mwuerms/ledtimer/(list of files, cad)

Other CAD files:
openscad/LT2/parts.scad
