mwuerms/ledtimer/kicad/LT2/rev0/LT2.kicad_pcb

## KiCad design kicad/LT2/rev0/LT2.kicad_pcb (2025-10-19)

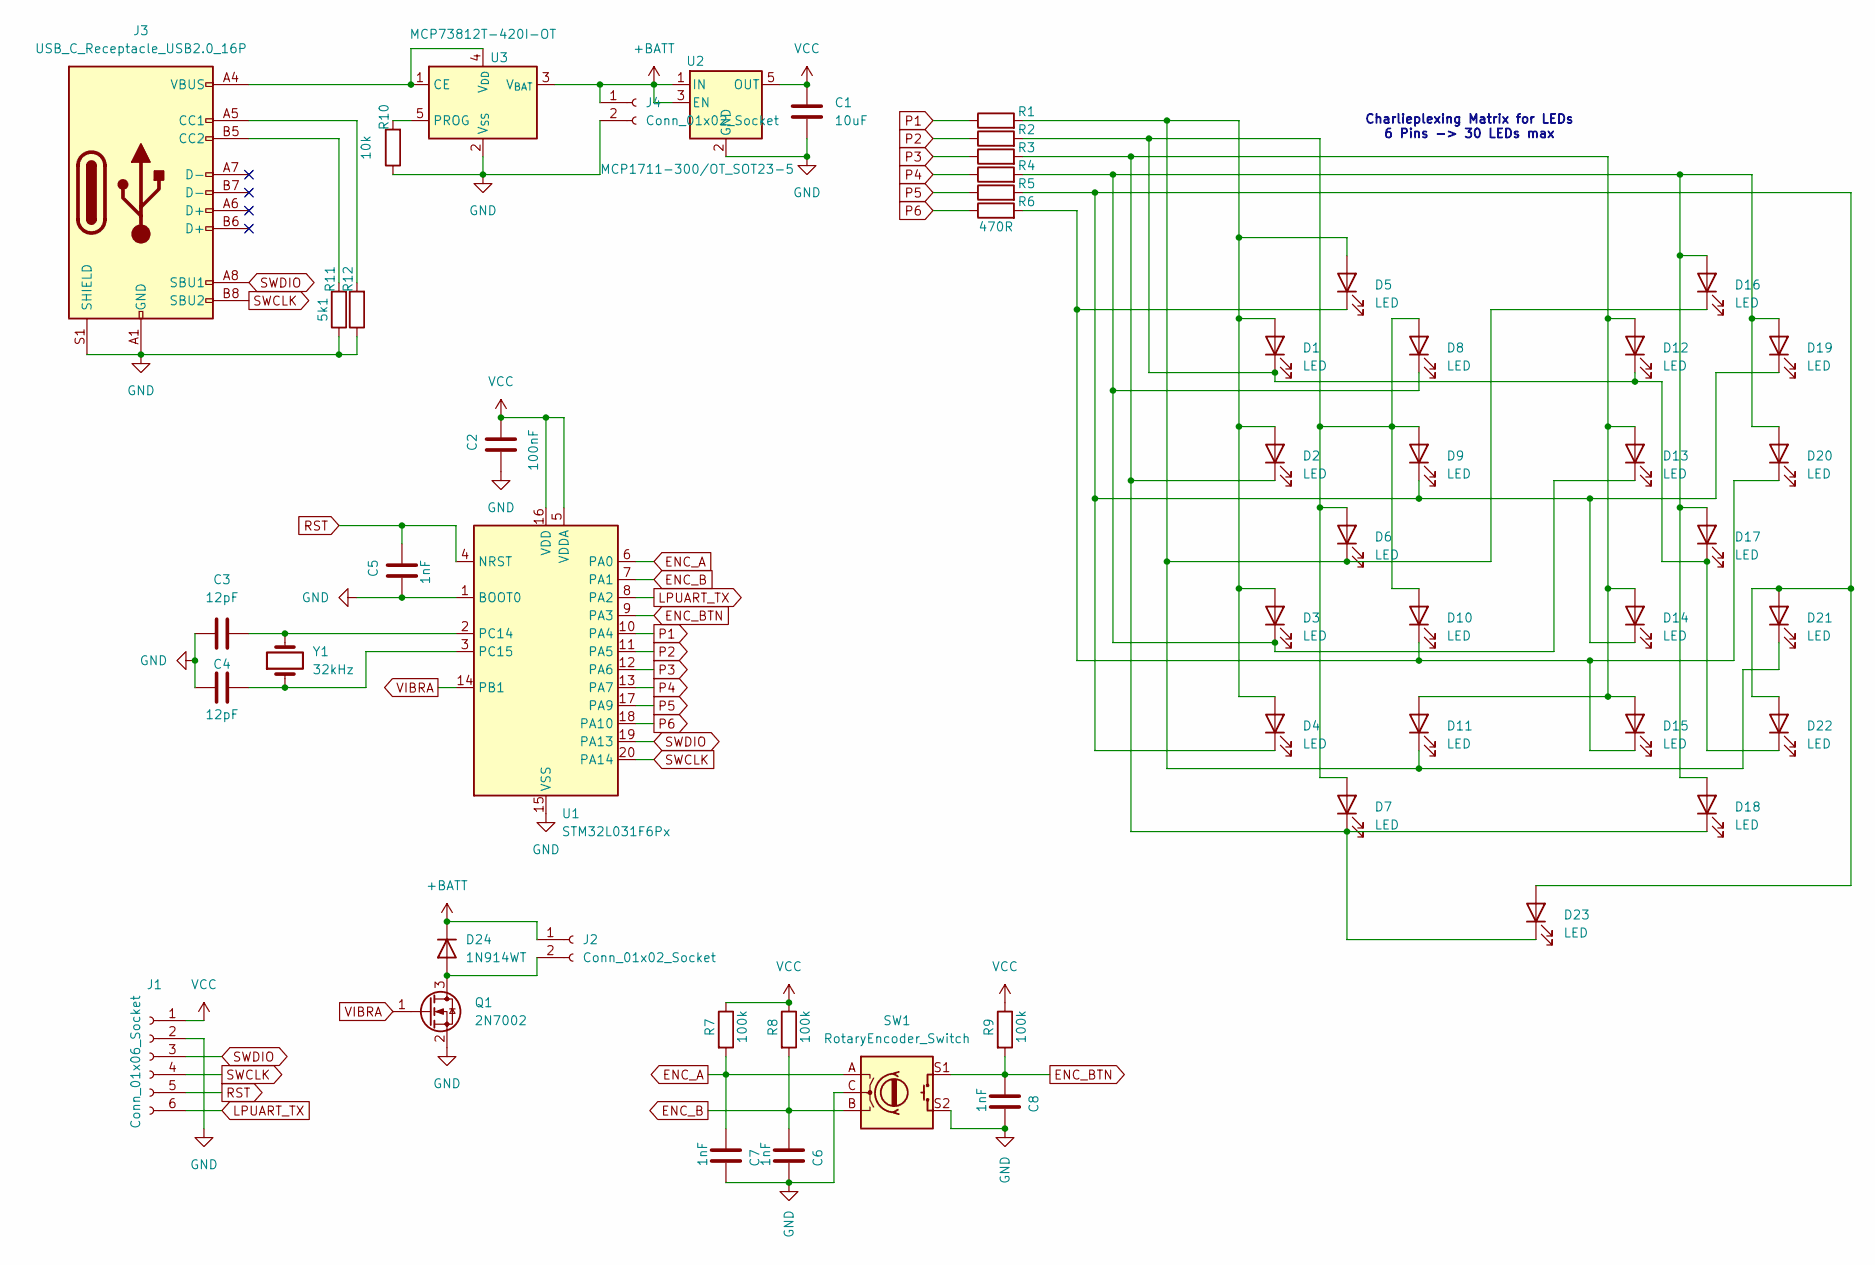
[picture p5: schematic LT2.kicad_sch, Led Timer 2]

Parts:
C1: 10uF; C_0805_2012Metric
C2: 100nF; C_0603_1608Metric
C3, C4: 12pF; C_0603_1608Metric
C5, C6, C7, C8: 1nF; C_0603_1608Metric
D1, D2, D3, D4, D5, D6, D7, D8, D9, D10, D11, D12, D13, D14, D15, D16, D17, D18, D19, D20, D21, D22, D23: LED; LED_0603_1608Metric_Pad1.05x0.95mm_HandSolder
D24: 1N914WT; D_SOD-523
J1: Conn_01x06_Socket; PinHeader_1x06_P1.27mm_Vertical
J2, J4: Conn_01x02_Socket; PinHeader_1x02_P1.27mm_Vertical
J3: USB_C_Receptacle_USB2.0_16P; USB_C_Receptacle_G-Switch_GT-USB-7010ASV
Q1: 2N7002; SOT-23
R1, R2, R3, R4, R5, R6: 470R; R_0603_1608Metric
R7, R8, R9: 100k; R_0603_1608Metric
R10: 10k; R_0603_1608Metric
R11, R12: 5k1; R_0603_1608Metric
SW1: RotaryEncoder_Switch; rotary_encoder_PEC11S-929K
U1: STM32L031F6Px; TSSOP-20_4.4x6.5mm_P0.65mm
U2: MCP1711-300/OT_SOT23-5; SOT-23-5
U3: MCP73812T-420I-OT; SOT-23-5
Y1: 32kHz; Crystal_SMD_3215-2Pin_3.2x1.5mm

Connections:
+BATT: D24.1 (K), J2.1, J4.1, U2.1 (IN), U2.3 (EN), U3.3 (V_{BAT})
ENC_A: C7.2, R7.2, SW1.A, U1.6 (PA0)
ENC_B: C6.2, R8.2, SW1.B, U1.7 (PA1)
ENC_BTN: C8.2, R9.2, SW1.S1, U1.9 (PA3)
GND: C1.2, C2.2, C3.1, C4.1, C5.2, C6.1, C7.1, C8.1, J1.2, J3.A1 (GND), J3.A12 (GND), J3.B1 (GND), J3.B12 (GND), J3.S1 (SHIELD), J4.2, Q1.2 (S), R10.1, R11.1, R12.1, SW1.C, SW1.S2, U1.1 (BOOT0), U1.15 (VSS), U2.2 (GND), U3.2 (V_{SS})
LPUART_TX: J1.6, U1.8 (PA2)
unnamed: D1.2 (A), D2.2 (A), D3.2 (A), D4.2 (A), D5.2 (A), D6.1 (K), D11.1 (K), D16.1 (K), D21.1 (K), R1.2
unnamed: D1.1 (K), D6.2 (A), D7.2 (A), D8.2 (A), D9.2 (A), D10.2 (A), D12.1 (K), D17.1 (K), D22.1 (K), R2.2
unnamed: D5.1 (K), D10.1 (K), D15.1 (K), D20.1 (K), R6.2
unnamed: D2.1 (K), D7.1 (K), D11.2 (A), D12.2 (A), D13.2 (A), D14.2 (A), D15.2 (A), D18.1 (K), D23.1 (K), R3.2
unnamed: D3.1 (K), D8.1 (K), D13.1 (K), D16.2 (A), D17.2 (A), D18.2 (A), D19.2 (A), D20.2 (A), R4.2
unnamed: D4.1 (K), D9.1 (K), D14.1 (K), D19.1 (K), D21.2 (A), D22.2 (A), D23.2 (A), R5.2
unnamed: D24.2 (A), J2.2, Q1.3 (D)
unnamed: J3.A5 (CC1), R12.2
unnamed: J3.B5 (CC2), R11.2
unnamed: C3.2, U1.2 (PC14), Y1.2
unnamed: C4.2, U1.3 (PC15), Y1.1
unnamed: J3.A4 (VBUS), J3.A9 (VBUS), J3.B4 (VBUS), J3.B9 (VBUS), U3.1 (CE), U3.4 (V_{DD})
unnamed: R10.2, U3.5 (PROG)
P1: R1.1, U1.10 (PA4)
P2: R2.1, U1.11 (PA5)
P3: R3.1, U1.12 (PA6)
P4: R4.1, U1.13 (PA7)
P5: R5.1, U1.17 (PA9)
P6: R6.1, U1.18 (PA10)
RST: C5.1, J1.5, U1.4 (NRST)
SWCLK: J1.4, J3.B8 (SBU2), U1.20 (PA14)
SWDIO: J1.3, J3.A8 (SBU1), U1.19 (PA13)
VCC: C1.1, C2.1, J1.1, R7.1, R8.1, R9.1, U1.5 (VDDA), U1.16 (VDD), U2.5 (OUT)
VIBRA: Q1.1 (G), U1.14 (PB1)

Notes on the sheet:
Charlieplexing Matrix for LEDs 6 Pins -> 30 LEDs max

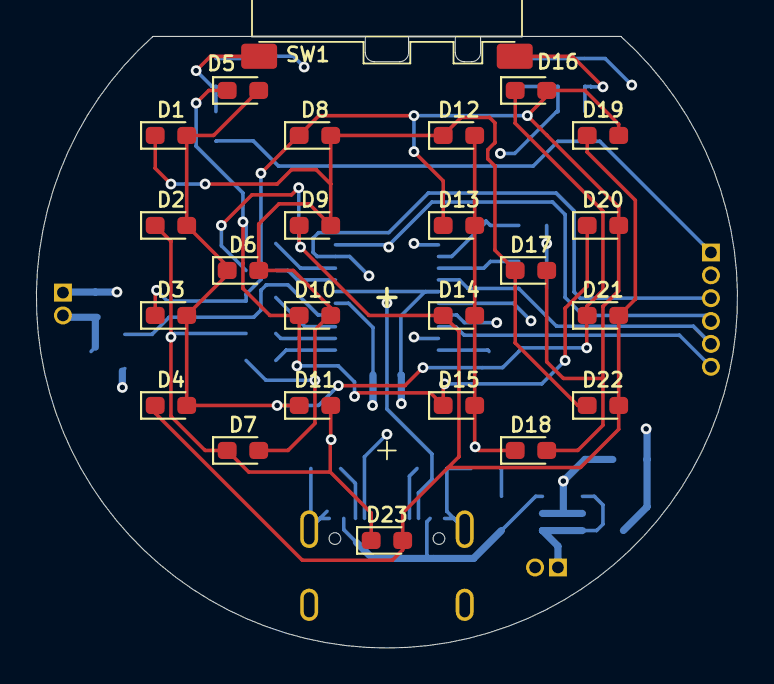
[picture p6: board LT2.kicad_pcb from above]

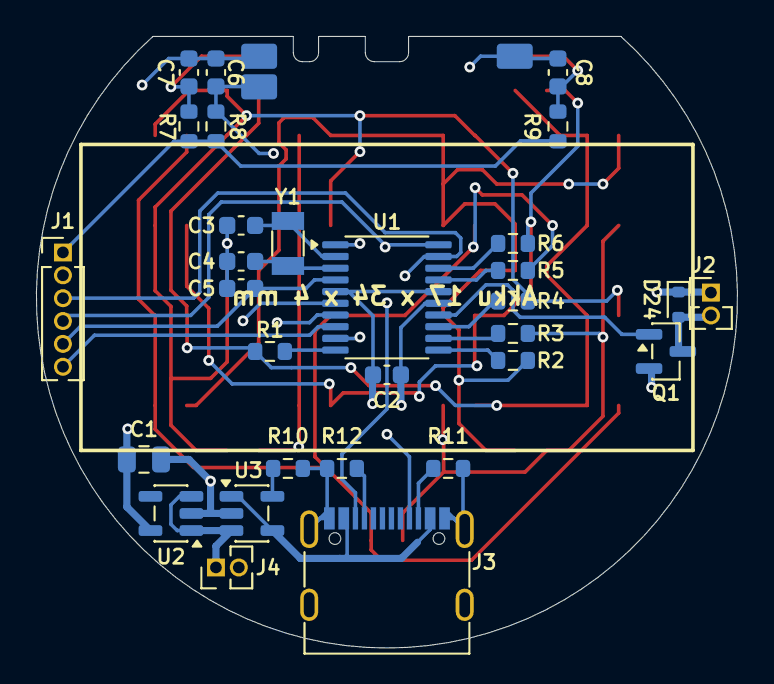
[picture p7: board LT2.kicad_pcb from below]

Board: 4 copper layers, 38.9 x 34.0 mm, 54 parts (30 on the bottom side), 30 nets.
