mwuerms/ledtimer/kicad/LT1/LT1.kicad_pcb

## KiCad design kicad/LT1/LT1.kicad_pcb (2023-09-27)

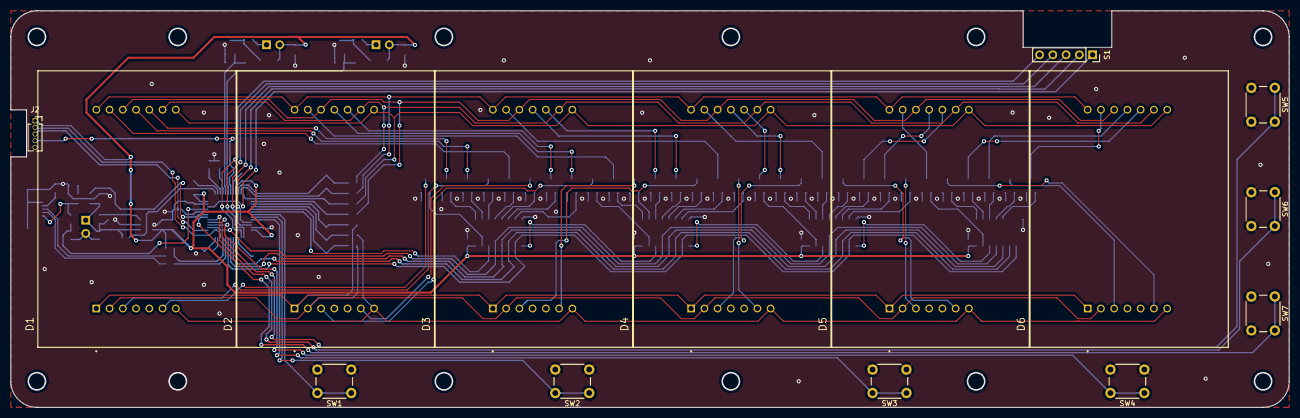
[picture p8: board LT1.kicad_pcb from above]

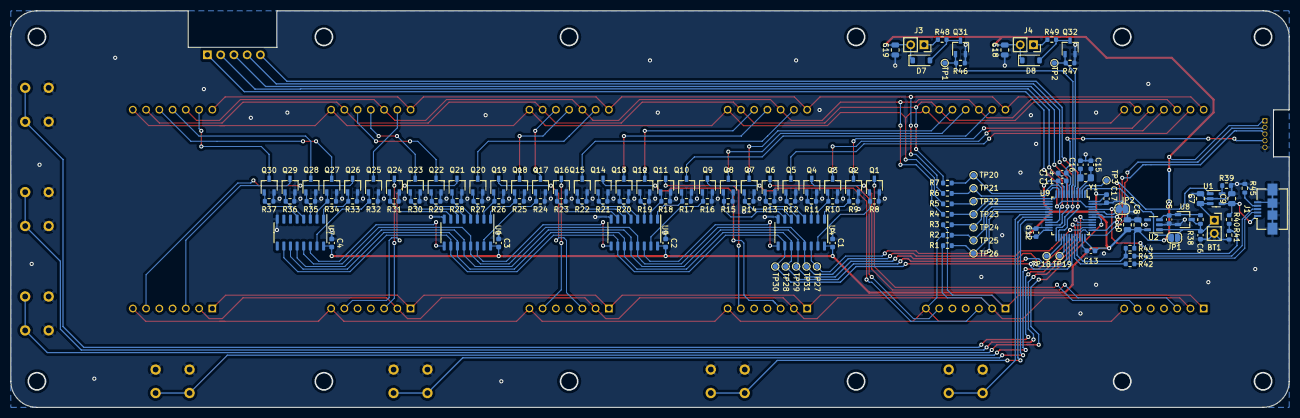
[picture p9: board LT1.kicad_pcb from below]

Board: 2 copper layers, 245.0 x 76.0 mm, 149 parts (134 on the bottom side), 123 nets.

Parts:
BT1: Battery_Cell; PinSocket_1x02_P2.54mm_Vertical
C1, C2, C3, C4, C6, C11, C12, C13, C17: 100nF; C_0603_1608Metric
C5, C14: 10nF; C_0603_1608Metric
C7, C8, C9, C10, C18, C19: 10uF; C_0805_2012Metric
C15, C16: C_0603_1608Metric
D1, D2, D3, D4, D5, D6: TC20-11SRWA; LED_TC20-11SRWA
D7, D8: D_Schottky; D_SOD-123
J1: USB_B_Micro; USB_Micro-B_Amphenol_10104110_Horizontal
J2: Conn_01x05_Socket; PinSocket_1x05_P1.27mm_Vertical
J3, J4: Conn_01x02_Socket; PinSocket_1x02_P2.54mm_Vertical
JP1: SolderJumper_2_Open; SolderJumper-2_P1.3mm_Open_RoundedPad1.0x1.5mm
JP2: SolderJumper_2_Bridged; SolderJumper-2_P1.3mm_Bridged_RoundedPad1.0x1.5mm
Q1, Q2, Q3, Q4, Q5, Q6, Q7, Q8, Q9, Q10, Q11, Q12, Q13, Q14, Q15, Q16, Q17, Q18, Q19, Q20, Q21, Q22, Q23, Q24, Q25, Q26, Q27, Q28, Q29, Q30, Q31, Q32: 2N7002K; TSOT-23
R1, R2, R3, R4, R5, R6, R7: 150R; R_0603_1608Metric
R8, R9, R10, R11, R12, R13, R14, R15, R16, R17, R18, R19, R20, R21, R22, R23, R24, R25, R26, R27, R28, R29, R30, R31, R32, R33, R34, R35, R36, R37, R38, R39, R46, R47, R48, R49: 1M; R_0603_1608Metric
R40, R41, R45: 10k; R_0603_1608Metric
R42, R43: 10R; R_0603_1608Metric
R44: 1k5; R_0603_1608Metric
S1: MF140; PinSocket_1x05_P2.54mm_Vertical
SW1, SW2, SW3, SW4, SW5, SW6, SW7: SW_Push; SW_PUSH_6mm_H9.5mm
TP1, TP2, TP3, TP18, TP19, TP20, TP21, TP22, TP23, TP24, TP25, TP26, TP27, TP28, TP29, TP30, TP31: TestPoint; TestPoint_Pad_D1.0mm
U1: MCP73831-2-OT; SOT-23-5
U2: TLV75533PDBV; SOT-23-5
U4, U5, U6, U7: 74HC595D; SO-16_3.9x9.9mm_P1.27mm
U8: MCP111T-xxxE_TT; TSOT-23
U9: STM32L412C8Tx; LQFP-48_7x7mm_P0.5mm
Y1: 32 kHz (ABS06); R_0805_2012Metric_Pad1.20x1.40mm_HandSolder

Connections:
+3.3V: C1.1, C2.1, C3.1, C4.1, C8.1, C10.1, C11.1, C12.1, C13.1, C17.1, C18.1, C19.1, D7.1 (K), D8.1 (K), J2.1, J3.2, J4.2, R44.2, U2.5 (OUT), U4.16 (VCC), U5.16 (VCC), U6.16 (VCC), U7.16 (VCC), U9.9 (VDDA), U9.24 (VDD), U9.36 (VDDUSB), U9.48 (VDD)
+BATT: BT1.1 (+), C6.1, C7.1, JP1.1 (A), R38.1, U1.3 (V_{BAT}), U2.1 (IN), U8.3 (VDD)
ALM0: Q31.1 (G), R46.1, TP1.1, U9.6 (PH1)
ALM1: Q32.1 (G), R47.1, TP2.1, U9.5 (PH0)
BTN_MODE: SW6.1, U9.41 (PB5)
BTN_PLAY: SW5.1, U9.40 (PB4)
BTN_STOP: SW7.1, U9.42 (PB6)
BTN_UP1: SW1.1, U9.18 (PB0)
BTN_UP2: SW2.1, U9.19 (PB1)
BTN_UP3: SW3.1, U9.20 (PB2)
BTN_UP4: SW4.1, U9.39 (PB3)
CH_STAT: U1.1 (STAT), U9.43 (PB7)
DISP_COL_OE: TP31.1, U4.13 (~OE), U5.13 (~OE), U6.13 (~OE), U7.13 (~OE), U9.38 (PA15)
DISP_COL_RCLK: TP29.1, U4.12 (RCLK), U5.12 (RCLK), U6.12 (RCLK), U7.12 (RCLK), U9.30 (PA9)
DISP_COL_SER: TP27.1, U4.14 (SER), U9.17 (PA7)
DISP_COL_SRCLK: TP28.1, U4.11 (SRCLK), U5.11 (SRCLK), U6.11 (SRCLK), U7.11 (SRCLK), U9.29 (PA8)
DISP_COL_SRCLR: TP30.1, U4.10 (~SRCLR), U5.10 (~SRCLR), U6.10 (~SRCLR), U7.10 (~SRCLR), U9.31 (PA10)
DISP_ROW0: R7.1, TP20.1, U9.10 (PA0)
DISP_ROW1: R6.1, TP21.1, U9.11 (PA1)
DISP_ROW2: R5.1, TP22.1, U9.12 (PA2)
DISP_ROW3: R4.1, TP23.1, U9.13 (PA3)
DISP_ROW4: R3.1, TP24.1, U9.14 (PA4)
DISP_ROW5: R2.1, TP25.1, U9.15 (PA5)
DISP_ROW6: R1.1, TP26.1, U9.16 (PA6)
GND: BT1.2 (-), C1.2, C2.2, C3.2, C4.2, C5.2, C6.2, C7.2, C8.2, C9.2, C10.2, C11.2, C12.2, C13.2, C14.2, C15.1, C16.1, C17.2, C18.2, C19.2, J1.5 (GND), J1.6 (Shield), J2.5, JP2.1 (A), Q1.2 (S), Q2.2 (S), Q3.2 (S), Q4.2 (S), Q5.2 (S), Q6.2 (S), Q7.2 (S), Q8.2 (S), Q9.2 (S), Q10.2 (S), Q11.2 (S), Q12.2 (S), Q13.2 (S), Q14.2 (S), Q15.2 (S), Q16.2 (S), Q17.2 (S), Q18.2 (S), Q19.2 (S), Q20.2 (S), Q21.2 (S), Q22.2 (S), Q23.2 (S), Q24.2 (S), Q25.2 (S), Q26.2 (S), Q27.2 (S), Q28.2 (S), Q29.2 (S), Q30.2 (S), Q31.2 (S), Q32.2 (S), R8.2, R9.2, R10.2, R11.2, R12.2, R13.2, R14.2, R15.2, R16.2, R17.2, R18.2, R19.2, R20.2, R21.2, R22.2, R23.2, R24.2, R25.2, R26.2, R27.2, R28.2, R29.2, R30.2, R31.2, R32.2, R33.2, R34.2, R35.2, R36.2, R37.2, R39.2, R41.2, R45.2, R46.2, R47.2, SW1.2, SW2.2, SW3.2, SW4.2, SW5.2, SW6.2, SW7.2, U1.2 (V_{SS}), U2.2 (GND), U4.8 (GND), U5.8 (GND), U6.8 (GND), U7.8 (GND), U8.2 (VSS), U9.8 (VSSA), U9.23 (VSS), U9.35 (VSS), U9.47 (VSS)
unnamed: D1.13 (C1), Q5.3 (D)
unnamed: D1.3 (C2), Q4.3 (D)
unnamed: D1.11 (C3), Q3.3 (D)
unnamed: D1.10 (C4), Q2.3 (D)
unnamed: D1.6 (C5), Q1.3 (D)
unnamed: D1.9 (R1), D2.9 (R1), D3.9 (R1), D4.9 (R1), D5.9 (R1), D6.9 (R1), R7.2
unnamed: D1.14 (R2), D2.14 (R2), D3.14 (R2), D4.14 (R2), D5.14 (R2), D6.14 (R2), R6.2
unnamed: D1.8 (R3), D2.8 (R3), D3.8 (R3), D4.8 (R3), D5.8 (R3), D6.8 (R3), R5.2
unnamed: D1.12 (R4), D2.12 (R4), D3.12 (R4), D4.12 (R4), D5.12 (R4), D6.12 (R4), R4.2
unnamed: D1.1 (R5), D2.1 (R5), D3.1 (R5), D4.1 (R5), D5.1 (R5), D6.1 (R5), R3.2
unnamed: D1.7 (R6), D2.7 (R6), D3.7 (R6), D4.7 (R6), D5.7 (R6), D6.7 (R6), R2.2
unnamed: D1.2 (R7), D2.2 (R7), D3.2 (R7), D4.2 (R7), D5.2 (R7), D6.2 (R7), R1.2
unnamed: D2.13 (C1), Q10.3 (D)
unnamed: D2.3 (C2), Q9.3 (D)
unnamed: D2.11 (C3), Q8.3 (D)
unnamed: D2.10 (C4), Q7.3 (D)
unnamed: D2.6 (C5), Q6.3 (D)
unnamed: D3.13 (C1), Q15.3 (D)
unnamed: D3.3 (C2), Q14.3 (D)
unnamed: D3.11 (C3), Q13.3 (D)
unnamed: D3.10 (C4), Q12.3 (D)
unnamed: D3.6 (C5), Q11.3 (D)
unnamed: D4.13 (C1), Q20.3 (D)
unnamed: D4.3 (C2), Q19.3 (D)
unnamed: D4.11 (C3), Q18.3 (D)
unnamed: D4.10 (C4), Q17.3 (D)
unnamed: D4.6 (C5), Q16.3 (D)
unnamed: D5.13 (C1), Q25.3 (D)
unnamed: D5.3 (C2), Q24.3 (D)
unnamed: D5.11 (C3), Q23.3 (D)
unnamed: D5.10 (C4), Q22.3 (D)
unnamed: D5.6 (C5), Q21.3 (D)
unnamed: D6.13 (C1), Q30.3 (D)
unnamed: D6.3 (C2), Q29.3 (D)
unnamed: D6.11 (C3), Q28.3 (D)
unnamed: D6.10 (C4), Q27.3 (D)
unnamed: D6.6 (C5), Q26.3 (D)
unnamed: D7.2 (A), Q31.3 (D), R48.2
unnamed: D8.2 (A), Q32.3 (D), R49.2
unnamed: J1.4 (ID), R45.1
unnamed: J3.1, R48.1
unnamed: J4.1, R49.1
unnamed: JP1.2 (B), U9.1 (VBAT)
unnamed: JP2.2 (B), U9.44 (PH3)
unnamed: Q1.1 (G), R8.1, U4.15 (QA)
unnamed: Q2.1 (G), R9.1, U4.1 (QB)
unnamed: Q3.1 (G), R10.1, U4.2 (QC)
unnamed: Q4.1 (G), R11.1, U4.3 (QD)
unnamed: Q5.1 (G), R12.1, U4.4 (QE)
unnamed: Q6.1 (G), R13.1, U4.5 (QF)
unnamed: Q7.1 (G), R14.1, U4.6 (QG)
unnamed: Q8.1 (G), R15.1, U4.7 (QH)
unnamed: Q9.1 (G), R16.1, U5.15 (QA)
unnamed: Q10.1 (G), R17.1, U5.1 (QB)
unnamed: Q11.1 (G), R18.1, U5.2 (QC)
unnamed: Q12.1 (G), R19.1, U5.3 (QD)
unnamed: Q13.1 (G), R20.1, U5.4 (QE)
unnamed: Q14.1 (G), R21.1, U5.5 (QF)
unnamed: Q15.1 (G), R22.1, U5.6 (QG)
unnamed: Q16.1 (G), R23.1, U5.7 (QH)
unnamed: Q17.1 (G), R24.1, U6.15 (QA)
unnamed: Q18.1 (G), R25.1, U6.1 (QB)
unnamed: Q19.1 (G), R26.1, U6.2 (QC)
unnamed: Q20.1 (G), R27.1, U6.3 (QD)
unnamed: Q21.1 (G), R28.1, U6.4 (QE)
unnamed: Q22.1 (G), R29.1, U6.5 (QF)
unnamed: Q23.1 (G), R30.1, U6.6 (QG)
unnamed: Q24.1 (G), R31.1, U6.7 (QH)
unnamed: Q25.1 (G), R32.1, U7.15 (QA)
unnamed: Q26.1 (G), R33.1, U7.1 (QB)
unnamed: Q27.1 (G), R34.1, U7.2 (QC)
unnamed: Q28.1 (G), R35.1, U7.3 (QD)
unnamed: Q29.1 (G), R36.1, U7.4 (QE)
unnamed: Q30.1 (G), R37.1, U7.5 (QF)
unnamed: R39.1, U1.5 (PROG)
unnamed: C5.1, R38.2, U2.3 (EN), U8.1 (VOUT)
unnamed: U4.9 (QH'), U5.14 (SER)
unnamed: U5.9 (QH'), U6.14 (SER)
unnamed: U6.9 (QH'), U7.14 (SER)
unnamed: R42.1, U9.32 (PA11)
unnamed: R43.1, R44.1, U9.33 (PA12)
unnamed: TP18.1, U9.27 (PB14)
unnamed: TP19.1, U9.28 (PB15)
unnamed: TP3.1, U9.2 (PC13)
unnamed: C15.2, U9.3 (PC14), Y1.2
unnamed: C16.2, U9.4 (PC15), Y1.1
SW0: S1.1, U9.46 (PB9)
SW1: S1.2, U9.21 (PB10)
SW2: S1.3, U9.22 (PB11)
SW3: S1.4, U9.25 (PB12)
SW4: S1.5, U9.26 (PB13)
SWDCLK: J2.3, U9.37 (PA14)
SWDIO: J2.2, U9.34 (PA13)
USBD+: J1.3 (D+), R43.2
USBD-: J1.2 (D-), R42.2
USB_STAT: R40.2, R41.1, U9.45 (PB8)
VBUS: C9.1, J1.1 (VBUS), R40.1, U1.4 (V_{DD})
nRST: C14.1, J2.4, U9.7 (NRST)
