mwuerms/ledtimer/stmcubeide/LT2/Core/Src/main.c

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
/* Includes ------------------------------------------------------------------*/
#include "main.h"
#include "rtc.h"
#include "tim.h"
#include "gpio.h"

/* USER CODE BEGIN Includes */
#include "encoder.h"
#include "disp.h"
/* USER CODE END Includes */


void SystemClock_Config(void);
/* USER CODE BEGIN 0 */
static int8_t main_task_func(uint8_t event, void *data);
static task_t main_task = {.name = "main task", .task = main_task_func};
int8_t main_tid;

// states
#define MAIN_ST_OFF (0)
#define MAIN_ST_SET_TIMER (1)
#define MAIN_ST_RUNNING (2)
#define MAIN_ST_RUNNING_DISP_OFF (3)
#define MAIN_ST_PAUSE (4)
#define MAIN_ST_ALARM (5)
#define MAIN_ST_TEST (6)

static struct {
	uint16_t state;
	struct {
		uint8_t min, sec;
	} timer_set, timer_cnt;
	uint16_t disp_timeout;
	uint8_t disp_state;
} main_task_ctrl = {
		.state = MAIN_ST_OFF,
};
#define TIMER_SET_MAX_MINUTES (99)
#define TIMER_SET_MIN_MINUTES (01)
#define TIMER_SET_SECONDS (59)

#define TIMER_DISP_ON_TIMEOUT (30) // in s
#define TIMER_DISP_ALARM_TIMEOUT (30) // in s

static inline void vibra_off(void) {
	LL_GPIO_ResetOutputPin(VIBRA_GPIO_Port, VIBRA_Pin);
}

static inline void vibra_on(void) {
	LL_GPIO_SetOutputPin(VIBRA_GPIO_Port, VIBRA_Pin);
}

static int8_t main_task_func(uint8_t event, void *data) {
	switch(main_task_ctrl.state) {
	// -------------------------------------------------------------------------
	case MAIN_ST_OFF:
		if( (event == EV_START) ||
			(event == EV_ENC_SINGLE_PRESSED)) {
			// was in off state
			power_mode_request(POWER_MODE_SLEEP); // to display time and timer functionalities
			main_task_ctrl.state = MAIN_ST_SET_TIMER;
			main_task_ctrl.timer_set.min = 1;
			main_task_ctrl.timer_set.sec = 0;
			disp_on();
			disp_show_number(main_task_ctrl.timer_set.min);
			main_task_ctrl.disp_timeout = TIMER_DISP_ON_TIMEOUT;
			rtc_start_1s_timing_event();
			encoder_btn_use_debounce();
			vibra_off();
		}
		break;

	// -------------------------------------------------------------------------
	case MAIN_ST_SET_TIMER:
		if(event == EV_TIMER_RTC) { // timeout--
			if(main_task_ctrl.disp_timeout) {
				main_task_ctrl.disp_timeout--;
				if(main_task_ctrl.disp_timeout == 0) {
					// expired
					main_task_ctrl.state = MAIN_ST_OFF;
					power_mode_release(POWER_MODE_SLEEP);
					rtc_stop_timing_event();
					encoder_btn_use_int_only();
					disp_off();
					vibra_off();
				}
			}
		}
		if(event == EV_ENC_ROT_RIGHT) { // +
			main_task_ctrl.disp_timeout = TIMER_DISP_ON_TIMEOUT; // reset timeout
			if(main_task_ctrl.timer_set.min < TIMER_SET_MAX_MINUTES) {
				main_task_ctrl.timer_set.min++;
				disp_show_number(main_task_ctrl.timer_set.min);
			}
		}
		if(event == EV_ENC_ROT_LEFT) { // -
			main_task_ctrl.disp_timeout = TIMER_DISP_ON_TIMEOUT; // reset timeout
			if(main_task_ctrl.timer_set.min > TIMER_SET_MIN_MINUTES) {
				main_task_ctrl.timer_set.min--;
				disp_show_number(main_task_ctrl.timer_set.min);
			}
		}
		if(event == EV_ENC_SINGLE_PRESSED) { // start
			main_task_ctrl.state = MAIN_ST_RUNNING;
			main_task_ctrl.timer_cnt.min = main_task_ctrl.timer_set.min;
			main_task_ctrl.timer_cnt.sec = main_task_ctrl.timer_set.sec;
			disp_show_number(main_task_ctrl.timer_cnt.min);
			disp_activity_on();
			rtc_start_1s_timing_event();
		}
		if(event == EV_ENC_LONG_PRESSED) { // stop, off
			main_task_ctrl.state = MAIN_ST_OFF;
			power_mode_release(POWER_MODE_SLEEP);
			rtc_stop_timing_event();
			encoder_btn_use_int_only();
			disp_off();
		}
		break;

	// -------------------------------------------------------------------------
	case MAIN_ST_RUNNING:
		if(event == EV_TIMER_RTC) { // timeout--
			main_task_ctrl.disp_state = 1;
			if(main_task_ctrl.timer_cnt.sec == 0) {
				if(main_task_ctrl.timer_cnt.min == 0) {
					// expired: ALARM
					main_task_ctrl.state = MAIN_ST_ALARM;
					main_task_ctrl.disp_state = 0;
					main_task_ctrl.disp_timeout = TIMER_DISP_ALARM_TIMEOUT;
					disp_show_number(main_task_ctrl.timer_set.min);
					vibra_on();
				}
				else {
					main_task_ctrl.timer_cnt.sec = TIMER_SET_SECONDS;
					main_task_ctrl.timer_cnt.min--;
				}
			}
			else {
				main_task_ctrl.timer_cnt.sec--;
			}

			if(main_task_ctrl.timer_cnt.min) {
				disp_show_number(main_task_ctrl.timer_cnt.min);
			}
			else {
				disp_show_number(main_task_ctrl.timer_cnt.sec);
			}
			if(main_task_ctrl.disp_state) {
				if(main_task_ctrl.timer_cnt.sec & 0x01)
					disp_activity_on();
				else
					disp_activity_off();
			}
		}
		if(event == EV_ENC_SINGLE_PRESSED) { // pause
			main_task_ctrl.state = MAIN_ST_PAUSE;
			rtc_start_1s_timing_event();
			if(main_task_ctrl.timer_cnt.min) {
				disp_show_number(main_task_ctrl.timer_cnt.min);
			}
			else {
				disp_show_number(main_task_ctrl.timer_cnt.sec);
			}
			disp_activity_off();
			main_task_ctrl.disp_state = 0;
		}
		if(event == EV_ENC_LONG_PRESSED) { // stop, set time
			main_task_ctrl.state = MAIN_ST_SET_TIMER;
			disp_show_number(main_task_ctrl.timer_set.min);
			main_task_ctrl.disp_timeout = TIMER_DISP_ON_TIMEOUT;
			rtc_start_1s_timing_event();
		}
		break;

	// -------------------------------------------------------------------------
	case MAIN_ST_RUNNING_DISP_OFF:
		break;

	// -------------------------------------------------------------------------
	case MAIN_ST_PAUSE:
		if(event == EV_TIMER_RTC) { // blink time
			if(main_task_ctrl.disp_state == 0) {
				main_task_ctrl.disp_state = 1;
				disp_number_off();
			}
			else {
				main_task_ctrl.disp_state = 0;
				if(main_task_ctrl.timer_cnt.min) {
					disp_show_number(main_task_ctrl.timer_cnt.min);
				}
				else {
					disp_show_number(main_task_ctrl.timer_cnt.sec);
				}
			}
		}
		if(event == EV_ENC_SINGLE_PRESSED) { // resume
			main_task_ctrl.state = MAIN_ST_RUNNING;
			disp_show_number(main_task_ctrl.timer_cnt.min);
			disp_activity_on();
			rtc_start_1s_timing_event();
		}
		if(event == EV_ENC_LONG_PRESSED) { // stop, set time
			main_task_ctrl.state = MAIN_ST_SET_TIMER;
			disp_show_number(main_task_ctrl.timer_set.min);
			main_task_ctrl.disp_timeout = TIMER_DISP_ON_TIMEOUT;
			rtc_start_1s_timing_event();
		}
		break;

	// -------------------------------------------------------------------------// -------------------------------------------------------------------------
	case MAIN_ST_ALARM:
		if(event == EV_TIMER_RTC) { // blink time
			if(main_task_ctrl.disp_timeout) {
				main_task_ctrl.disp_timeout--;
				if(main_task_ctrl.disp_timeout == 0) {
					// expired
					main_task_ctrl.state = MAIN_ST_SET_TIMER;
					disp_show_number(main_task_ctrl.timer_set.min);
					main_task_ctrl.disp_timeout = TIMER_DISP_ON_TIMEOUT;
					rtc_start_1s_timing_event();
					vibra_off();
					break;
				}
			}
			if(main_task_ctrl.disp_state == 0) {
				main_task_ctrl.disp_state = 1;
				disp_number_off();
				vibra_off();
			}
			else {
				main_task_ctrl.disp_state = 0;
				disp_show_number(main_task_ctrl.timer_set.min);
				vibra_on();
			}
		}
		if( (event == EV_ENC_SINGLE_PRESSED) ||
			(event == EV_ENC_LONG_PRESSED)) { // done, go back to set time
			main_task_ctrl.state = MAIN_ST_SET_TIMER;
			disp_show_number(main_task_ctrl.timer_set.min);
			main_task_ctrl.disp_timeout = TIMER_DISP_ON_TIMEOUT;
			rtc_start_1s_timing_event();
			vibra_off();
		}
		break;
	}

	return 1; // stay on
}

/*
 * power modes, cases
 *
 * 1. case 0: nothing to do, no data to preserve
 *   + available power modes: **stop**
 *   + all power down,
 *   + wakeup by rotary encoder, press or rotate -> EXTI, GPIO only
 *   + available power modes:
 *     + GPIO + EXTI: run; sleep; low-power run; low-power-sleep; stop; wake up from standby:
 *       + PA0: WKUP1: ENC_A_Pin -> rotate knob to wake
 *       + PA2: WKUP3: unused (UART2_TX)
 * 2. case 1: display, setup time, count down time
 *   + use power mode: **sleep**
 *   + active: rotary encoder + button -> 16-bit timers
 *   + RTC timer
 *   + display -> 16-bit timers
 *   + CPU may be off, when there is nothing to do
 *   + available power modes:
 *     + 16-bit timers: run; **sleep**; low-power run; low-power-sleep; - ; -
 *     + RTC: run; sleep; low-power run; low-power-sleep; stop; standby
 */

/* USER CODE END 0 */

/**
  * @brief  The application entry point.
  * @retval int
  */
int main(void)
{

  /* MCU Configuration--------------------------------------------------------*/

  /* Reset of all peripherals, Initializes the Flash interface and the Systick. */
  LL_APB2_GRP1_EnableClock(LL_APB2_GRP1_PERIPH_SYSCFG);
  LL_APB1_GRP1_EnableClock(LL_APB1_GRP1_PERIPH_PWR);

  /* SysTick_IRQn interrupt configuration */
  NVIC_SetPriority(SysTick_IRQn, 3);

  /* Configure the system clock */
  SystemClock_Config();

  /* Initialize all configured peripherals */
  MX_GPIO_Init();
  MX_RTC_Init();
  MX_TIM22_Init();
  MX_TIM2_Init();
  MX_TIM21_Init();
  /* USER CODE BEGIN 2 */
	scheduler_init();
	//power_mode_request(POWER_MODE_SLEEP); // to display time and timer functionalities
	power_mode_request(POWER_MODE_STOP); // no to do: power down everything, but generate INT on encoder input

	encoder_init();
	disp_init();
	vibra_off();

	scheduler_add_task(&main_task);
	main_tid = main_task.tid;
	scheduler_start_task(main_tid);

	// stay in scheduler
	scheduler_run();

  /* USER CODE END 2 */

  /* Infinite loop */
  /* USER CODE BEGIN WHILE */
	while (1)
	{
    /* USER CODE END WHILE */

    /* USER CODE BEGIN 3 */
	}
  /* USER CODE END 3 */
}

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
