mwuerms/ledtimer/stmcubeide/LT2/Core/Inc/main.h

#define EV_TIMER_RTC (1)
#define EV_TIMER_1 (2)
#define EV_ENC_SINGLE_PRESSED (11)
#define EV_ENC_DOUBLE_PRESSED (12)
#define EV_ENC_LONG_PRESSED (13)
#define EV_ENC_ROT_LEFT (14)
#define EV_ENC_ROT_RIGHT (15)
#define ENC_A_Pin LL_GPIO_PIN_0
#define ENC_A_GPIO_Port GPIOA
#define ENC_A_EXTI_IRQn EXTI0_1_IRQn
#define ENC_B_Pin LL_GPIO_PIN_1
#define ENC_B_GPIO_Port GPIOA
#define ENC_BTN_Pin LL_GPIO_PIN_3
#define ENC_BTN_GPIO_Port GPIOA
#define ENC_BTN_EXTI_IRQn EXTI2_3_IRQn
#define P1_Pin LL_GPIO_PIN_4
#define P1_GPIO_Port GPIOA
#define P2_Pin LL_GPIO_PIN_5
#define P2_GPIO_Port GPIOA
#define P3_Pin LL_GPIO_PIN_6
#define P3_GPIO_Port GPIOA
#define P4_Pin LL_GPIO_PIN_7
#define P4_GPIO_Port GPIOA
#define VIBRA_Pin LL_GPIO_PIN_1
#define VIBRA_GPIO_Port GPIOB
#define P5_Pin LL_GPIO_PIN_9
#define P5_GPIO_Port GPIOA
#define P6_Pin LL_GPIO_PIN_10
#define P6_GPIO_Port GPIOA
#define NVIC_PRIORITYGROUP_0         ((uint32_t)0x00000007) /*!< 0 bit  for pre-emption priority,
#define NVIC_PRIORITYGROUP_1         ((uint32_t)0x00000006) /*!< 1 bit  for pre-emption priority,
#define NVIC_PRIORITYGROUP_2         ((uint32_t)0x00000005) /*!< 2 bits for pre-emption priority,
#define NVIC_PRIORITYGROUP_3         ((uint32_t)0x00000004) /*!< 3 bits for pre-emption priority,
#define NVIC_PRIORITYGROUP_4         ((uint32_t)0x00000003) /*!< 4 bits for pre-emption priority,
