mwuerms/ledtimer/stmcubeide/LT1/Core/Inc/main.h

#define USR_BTN_Pin GPIO_PIN_13
#define USR_BTN_GPIO_Port GPIOC
#define USR_BTN_EXTI_IRQn EXTI15_10_IRQn
#define ALM0_Pin GPIO_PIN_0
#define ALM0_GPIO_Port GPIOH
#define ALM1_Pin GPIO_PIN_1
#define ALM1_GPIO_Port GPIOH
#define DISP_ROW0_Pin GPIO_PIN_0
#define DISP_ROW0_GPIO_Port GPIOA
#define DISP_ROW1_Pin GPIO_PIN_1
#define DISP_ROW1_GPIO_Port GPIOA
#define DISP_ROW2_Pin GPIO_PIN_2
#define DISP_ROW2_GPIO_Port GPIOA
#define DISP_ROW3_Pin GPIO_PIN_3
#define DISP_ROW3_GPIO_Port GPIOA
#define DISP_ROW4_Pin GPIO_PIN_4
#define DISP_ROW4_GPIO_Port GPIOA
#define DISP_ROW5_Pin GPIO_PIN_5
#define DISP_ROW5_GPIO_Port GPIOA
#define DISP_ROW6_Pin GPIO_PIN_6
#define DISP_ROW6_GPIO_Port GPIOA
#define DISP_COL_SER_Pin GPIO_PIN_7
#define DISP_COL_SER_GPIO_Port GPIOA
#define BTN_UP0_Pin GPIO_PIN_0
#define BTN_UP0_GPIO_Port GPIOB
#define BTN_UP0_EXTI_IRQn EXTI0_IRQn
#define BTN_UP1_Pin GPIO_PIN_1
#define BTN_UP1_GPIO_Port GPIOB
#define BTN_UP1_EXTI_IRQn EXTI1_IRQn
#define BTN_UP2_Pin GPIO_PIN_2
#define BTN_UP2_GPIO_Port GPIOB
#define BTN_UP2_EXTI_IRQn EXTI2_IRQn
#define SW1_Pin GPIO_PIN_10
#define SW1_GPIO_Port GPIOB
#define SW2_Pin GPIO_PIN_11
#define SW2_GPIO_Port GPIOB
#define SW3_Pin GPIO_PIN_12
#define SW3_GPIO_Port GPIOB
#define SW4_Pin GPIO_PIN_13
#define SW4_GPIO_Port GPIOB
#define DISP_COL_SRCLK_Pin GPIO_PIN_8
#define DISP_COL_SRCLK_GPIO_Port GPIOA
#define DISP_COL_RCLK_Pin GPIO_PIN_9
#define DISP_COL_RCLK_GPIO_Port GPIOA
#define DISP_COL_SRCLR_Pin GPIO_PIN_10
#define DISP_COL_SRCLR_GPIO_Port GPIOA
#define DISP_COL_OE_Pin GPIO_PIN_15
#define DISP_COL_OE_GPIO_Port GPIOA
#define BTN_UP3_Pin GPIO_PIN_3
#define BTN_UP3_GPIO_Port GPIOB
#define BTN_UP3_EXTI_IRQn EXTI3_IRQn
#define BTN_PLAY_Pin GPIO_PIN_4
#define BTN_PLAY_GPIO_Port GPIOB
#define BTN_PLAY_EXTI_IRQn EXTI4_IRQn
#define BTN_MODE_Pin GPIO_PIN_5
#define BTN_MODE_GPIO_Port GPIOB
#define BTN_MODE_EXTI_IRQn EXTI9_5_IRQn
#define BTN_STOP_Pin GPIO_PIN_6
#define BTN_STOP_GPIO_Port GPIOB
#define BTN_STOP_EXTI_IRQn EXTI9_5_IRQn
#define CH_STAT_Pin GPIO_PIN_7
#define CH_STAT_GPIO_Port GPIOB
#define USB_STAT_Pin GPIO_PIN_8
#define USB_STAT_GPIO_Port GPIOB
#define USB_STAT_EXTI_IRQn EXTI9_5_IRQn
#define SW0_Pin GPIO_PIN_9
#define SW0_GPIO_Port GPIOB
#define EV_WAKEUP	BIT(0)
#define EV_DISPLAY_UPDATE BIT(1)
#define EV_GPIO_POLL	BIT(2)
#define EV_MAINAPP_TIME	BIT(3)
#define EV_TIMER1APP_TIME BIT(4)
#define EV_BLINK	BIT(13)
#define EV_BLINK2	BIT(14)
#define EV_BUTTON_PRESSED	BIT(15)
