mwuerms/ledtimer/stmcubeide/LT1/Core/Src/lptim.c

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
/* Includes ------------------------------------------------------------------*/
#include "lptim.h"

/* USER CODE BEGIN 0 */
/* Includes ------------------------------------------------------------------*/
#include "macros.h"
#include "main.h"
#include "lptim.h"
#include "display.h"

/* USER CODE END 0 */

LPTIM_HandleTypeDef hlptim1;

/* LPTIM1 init function */
void MX_LPTIM1_Init(void)
{

  hlptim1.Instance = LPTIM1;
  hlptim1.Init.Clock.Source = LPTIM_CLOCKSOURCE_APBCLOCK_LPOSC;
  hlptim1.Init.Clock.Prescaler = LPTIM_PRESCALER_DIV1;
  hlptim1.Init.Trigger.Source = LPTIM_TRIGSOURCE_SOFTWARE;
  hlptim1.Init.OutputPolarity = LPTIM_OUTPUTPOLARITY_HIGH;
  hlptim1.Init.UpdateMode = LPTIM_UPDATE_IMMEDIATE;
  hlptim1.Init.CounterSource = LPTIM_COUNTERSOURCE_INTERNAL;
  hlptim1.Init.Input1Source = LPTIM_INPUT1SOURCE_GPIO;
  hlptim1.Init.Input2Source = LPTIM_INPUT2SOURCE_GPIO;
  hlptim1.Init.RepetitionCounter = 0;
  if (HAL_LPTIM_Init(&hlptim1) != HAL_OK)
  {
    Error_Handler();
  }
}

void HAL_LPTIM_MspInit(LPTIM_HandleTypeDef* lptimHandle)
{

  RCC_PeriphCLKInitTypeDef PeriphClkInit = {0};
  if(lptimHandle->Instance==LPTIM1)
  {
  /** Initializes the peripherals clock
  */
    PeriphClkInit.PeriphClockSelection = RCC_PERIPHCLK_LPTIM1;
    PeriphClkInit.Lptim1ClockSelection = RCC_LPTIM1CLKSOURCE_LSI;
    if (HAL_RCCEx_PeriphCLKConfig(&PeriphClkInit) != HAL_OK)
    {
      Error_Handler();
    }

    /* LPTIM1 clock enable */
    __HAL_RCC_LPTIM1_CLK_ENABLE();

    /* LPTIM1 interrupt Init */
    HAL_NVIC_SetPriority(LPTIM1_IRQn, 0, 0);
    HAL_NVIC_EnableIRQ(LPTIM1_IRQn);
  }
}

void HAL_LPTIM_MspDeInit(LPTIM_HandleTypeDef* lptimHandle)
{

  if(lptimHandle->Instance==LPTIM1)
  {
    /* Peripheral clock disable */
    __HAL_RCC_LPTIM1_CLK_DISABLE();

    /* LPTIM1 interrupt Deinit */
    HAL_NVIC_DisableIRQ(LPTIM1_IRQn);
  }
}

/* USER CODE BEGIN 1 */
// - private ---------------------------------
typedef struct {
	uint32_t ctrl;
	uint32_t periode_reload;
	uint32_t periode_cnt;
	uint32_t events;
} lptim_events_t;
#define LPTIM_EVENTS_CTRL_ACTIVE	BIT(31)
#define LPTIM_EVENTS_CTRL_REPEATE	BIT(30)

static volatile lptim_events_t lptim_events[LPTIM_NB_EVENTS];

static uint32_t lptim_Find_Free_Event(void){
	uint32_t n;
	for(n = 0; n < LPTIM_NB_EVENTS; n++) {
		if((lptim_events[n].ctrl & LPTIM_EVENTS_CTRL_ACTIVE) == 0) {
			// unused
			return n;
		}
	}
	return LPTIM_NB_EVENTS;
}

static volatile lptim_display_ctrl = 0;
#define LPTIM_DISPLAY_CTRL_ON	BIT(0)

static volatile uint32_t lptim2_event;
void HAL_LPTIM_AutoReloadMatchCallback(LPTIM_HandleTypeDef *hlptim) {
	if(hlptim == &hlptim1) {
		uint8_t n;
		for(n = 0; n < LPTIM_NB_EVENTS; n++) {
			if((lptim_events[n].ctrl & LPTIM_EVENTS_CTRL_ACTIVE)) {
				if(lptim_events[n].periode_cnt == 0) {
					global_events |= lptim_events[n].events;
					if((lptim_events[n].ctrl & LPTIM_EVENTS_CTRL_REPEATE)) {
						lptim_events[n].periode_cnt = lptim_events[n].periode_reload;
					}
					else {
						lptim_events[n].ctrl &= ~LPTIM_EVENTS_CTRL_ACTIVE;
					}
				}
				else {
					lptim_events[n].periode_cnt--;
				}
			}
		}
	}
	else {
		global_events |= lptim2_event;
		//display_Update();
	}
	if(global_events)
		HAL_PWR_DisableSleepOnExit();
}
// - public ---------------------------------
void lptim_Start(void) {
	HAL_LPTIM_Counter_Start_IT(&hlptim1, LPTIM_CLK_INTERVAL);
}

uint32_t lptim_AddSingleEvent(uint32_t periode, uint32_t event) {
	if(event == 0) {
		// error, cannot add event, there is none given
		// else this could result in a possible dead lock
		return LPTIM_COULD_NOT_ADD_EVENT;
	}

	// ATOMIC
	uint32_t restore_irq;
	ENTER_ATOMIC_NVIC_IRQn(LPTIM1_IRQn, restore_irq);

	// find 1st free lptim_events
	uint32_t ret = LPTIM_COULD_NOT_ADD_EVENT;	// default: no free lptim_event
	uint32_t lptim_event_nr = lptim_Find_Free_Event();
	if(lptim_event_nr < LPTIM_NB_EVENTS) {
		// found free lptim_event
		ret = lptim_event_nr;
		lptim_events[lptim_event_nr].periode_cnt = periode;
		lptim_events[lptim_event_nr].periode_reload = periode;
		lptim_events[lptim_event_nr].events = event;
		lptim_events[lptim_event_nr].ctrl = LPTIM_EVENTS_CTRL_ACTIVE;
	}

	LEAVE_ATOMIC_NVIC_IRQn(LPTIM1_IRQn, restore_irq);
	return ret;
}

uint32_t lptim_AddRepeatingEvent(uint32_t periode, uint32_t event) {
	if(event == 0) {
		// error, cannot add event, there is none given
		// else this could result in a possible dead lock
		return LPTIM_COULD_NOT_ADD_EVENT;
	}

	// ATOMIC
	uint32_t restore_irq;
	ENTER_ATOMIC_NVIC_IRQn(LPTIM1_IRQn, restore_irq);

	// find 1st free lptim_events
	uint32_t ret = LPTIM_COULD_NOT_ADD_EVENT;	// default: no free lptim_event
	uint32_t lptim_event_nr = lptim_Find_Free_Event();
	if(lptim_event_nr < LPTIM_NB_EVENTS) {
		// found free lptim_event
		ret = lptim_event_nr;
		lptim_events[lptim_event_nr].periode_cnt = periode;
		lptim_events[lptim_event_nr].periode_reload = periode;
		lptim_events[lptim_event_nr].events = event;
		lptim_events[lptim_event_nr].ctrl = LPTIM_EVENTS_CTRL_ACTIVE | LPTIM_EVENTS_CTRL_REPEATE;
	}

	LEAVE_ATOMIC_NVIC_IRQn(LPTIM1_IRQn, restore_irq);
	return ret;
}

uint32_t lptim_RemoveEvent(uint32_t lptim_event_nr) {
	if(lptim_event_nr >= LPTIM_NB_EVENTS) {
		return RET_ERROR;
	}

	// ATOMIC
	uint32_t restore_irq;
	ENTER_ATOMIC_NVIC_IRQn(LPTIM1_IRQn, restore_irq);

	lptim_events[lptim_event_nr].ctrl = 0;

	LEAVE_ATOMIC_NVIC_IRQn(LPTIM1_IRQn, restore_irq);
	return RET_SUCCESS;
}

static uint32_t lptim_display_nr = 0;
void lptim_StartDisplayUpdate(void) {
	// ATOMIC
	uint32_t restore_irq;
	ENTER_ATOMIC_NVIC_IRQn(LPTIM1_IRQn, restore_irq);

	lptim_display_nr = lptim_AddRepeatingEvent(1, EV_DISPLAY_UPDATE);

	LEAVE_ATOMIC_NVIC_IRQn(LPTIM1_IRQn, restore_irq);
}

void lptim_StopDisplayUpdate(void) {
	// ATOMIC
	uint32_t restore_irq;
	ENTER_ATOMIC_NVIC_IRQn(LPTIM1_IRQn, restore_irq);

	lptim_RemoveEvent(lptim_display_nr);

	LEAVE_ATOMIC_NVIC_IRQn(LPTIM1_IRQn, restore_irq);
}

/* USER CODE END 1 */
