mwuerms/ledtimer/stmcubeide/LT2/Core/Src/rtc.c

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
/* Includes ------------------------------------------------------------------*/
#include "rtc.h"

/* RTC init function */
void MX_RTC_Init(void)
{

  LL_RTC_InitTypeDef RTC_InitStruct = {0};

  /* Peripheral clock enable */
  LL_RCC_EnableRTC();

  /* RTC interrupt Init */
  NVIC_SetPriority(RTC_IRQn, 0);
  NVIC_EnableIRQ(RTC_IRQn);

  /** Initialize RTC and set the Time and Date
  */
  RTC_InitStruct.HourFormat = LL_RTC_HOURFORMAT_24HOUR;
  RTC_InitStruct.AsynchPrescaler = 127;
  RTC_InitStruct.SynchPrescaler = 255;
  LL_RTC_Init(RTC, &RTC_InitStruct);

  /** Initialize RTC and set the Time and Date
  */

  /** Enable the WakeUp
  */
  LL_RTC_WAKEUP_SetClock(RTC, LL_RTC_WAKEUPCLOCK_DIV_16);
}

/* USER CODE BEGIN 1 */
void rtc_start_1s_timing_event(void) {
	// Wakeup Timer konfigurieren (1 Hz)
	LL_RTC_DisableWriteProtection(RTC);
	LL_RTC_WAKEUP_Disable(RTC);
	//	    while(!LL_RTC_IsActiveFlag_WUTW(RTC));
	LL_RTC_WAKEUP_SetClock(RTC, LL_RTC_WAKEUPCLOCK_CKSPRE);
	LL_RTC_WAKEUP_SetAutoReload(RTC, 0);
	LL_RTC_ClearFlag_WUT(RTC);
	LL_RTC_EnableIT_WUT(RTC);
	LL_RTC_WAKEUP_Enable(RTC);
	LL_RTC_EnableWriteProtection(RTC);

	// Enable interrupt for EXTI line 20 (RTC)
	LL_EXTI_EnableIT_0_31(LL_EXTI_LINE_20);
  	// Trigger on rising edge for line 20 (RTC)
	LL_EXTI_EnableRisingTrig_0_31(LL_EXTI_LINE_20);

	NVIC_SetPriority(RTC_IRQn, 0);
	NVIC_EnableIRQ(RTC_IRQn);
}

void rtc_stop_timing_event(void) {
	LL_RTC_DisableWriteProtection(RTC);
	LL_RTC_ClearFlag_WUT(RTC);
	LL_RTC_DisableIT_WUT(RTC);
	LL_RTC_WAKEUP_Disable(RTC);
	LL_RTC_EnableWriteProtection(RTC);
	LL_EXTI_DisableIT_0_31(LL_EXTI_LINE_20);
}
/* USER CODE END 1 */
