mwuerms/ledtimer/stmcubeide/LT1/Core/Inc/lptim.h

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
/* Define to prevent recursive inclusion -------------------------------------*/
#ifndef __LPTIM_H__
#define __LPTIM_H__

#ifdef __cplusplus
extern "C" {
#endif

/* Includes ------------------------------------------------------------------*/
#include "main.h"

extern LPTIM_HandleTypeDef hlptim1;

void MX_LPTIM1_Init(void);

/* USER CODE BEGIN Prototypes */
#define LPTIM_SOURCE_CLK (32768UL)
#define LPTIM_CLK_INTERVAL (8)	// 8/32768 Hz = 244 us
#define LPTIM_NB_EVENTS	(4)

#define LPTIM_PERIODE_2MS	(10)	// 10 * 244 us = 2.44 ms
#define LPTIM_PERIODE_1S	(LPTIM_SOURCE_CLK/LPTIM_CLK_INTERVAL)
#define LPTIM_PERIODE_0_5S	(LPTIM_PERIODE_1S/2)


void lptim_Start(void);

#define LPTIM_COULD_NOT_ADD_EVENT (0xFFFFFFFF)
uint32_t lptim_AddSingleEvent(uint32_t periode, uint32_t event);
uint32_t lptim_AddRepeatingEvent(uint32_t periode, uint32_t event);
uint32_t lptim_RemoveEvent(uint32_t lptim_event_nr);

void lptim_StartDisplayUpdate(void);
void lptim_StopDisplayUpdate(void);

uint32_t lptim2_StartRepeating(uint32_t event);
uint32_t lptim2_Stop(void);
/* USER CODE END Prototypes */

#ifdef __cplusplus
}
#endif

#endif /* __LPTIM_H__ */
