mwuerms/ledtimer/(commit log)

2023-09-13 added some images, fonts and some openscad
    [7x5monospace.ods, ledtimer.scad, m3screw.scad, parts.scad]
2023-09-16 openscad: some changes to front plate kicad: started with schematics
    [LT1.kicad_pcb, LT1.kicad_sch, ledtimer.scad, parts.scad]
2023-09-20 schematics: added led matrix display, did much on MCU
    [LT1.kicad_sch]
2023-09-20 LT1 schema done
    [LT1.kicad_sch, LT1Display.kicad_sch]
2023-09-23 LT1 started with PCB, added driver for piezo and vibra alarm
    [LT1.kicad_pcb, LT1.kicad_sch, LT1Display.kicad_sch]
2023-09-24 LT1 some routing and placing
    [LT1.kicad_pcb, LT1.kicad_sch]
2023-09-27 LT1 all routed, gerber exported
    [LT1.kicad_pcb, LT1Display.kicad_sch]
2023-09-27 LT1: new stm32cubeide project created
2023-09-28 LT1: changed LT1.ioc to get EXTI (interrupts on gpios)
2023-09-30 LT1: addeded display_ShowBuffer gpio: reading buttons works, getting correct states
    [display.c, display.h, gpio.c, gpio.h, lptim.h, macros.h, main.c, main.h]
2023-10-17 LT1: using mainapp/timer1app_ProcessEvents()
2023-10-18 LT1: BOM + PDF exported
    [LT1_BOM.ods]
2023-10-18 LT1 timer1app set time
2023-12-13 LT1: Buttons working Display working but had to do 2 bugfixes: LED display was 180° rotated, but still flickering, need to adjust timing
    [dispBuffer.c, display.c, gpio.c, main.c]
2023-12-21 LT1: fixed timing, now display and gpios work both from foreground gpios tested, added func to detect button change
    [LT1.ioc, dispBuffer.c, display.c, gpio.c, gpio.h, lptim.c, lptim.h, main.c]
2023-12-21 LT1: timer1app setting time done
2023-12-26 LT1: added timer45minapp, there will be 1 single uninterruptable 45 min timing countdown
2024-01-02 LT1: new folder
    [ledtimer_testing.scad, m3screw.scad, parts.scad]
2024-01-02 LT1: added pcb with components
    [LT1.scad, parts.scad]
2025-10-08 started LED Timer 2
    [LT2.kicad_pcb, LT2.kicad_sch, LT2.scad]
2025-10-18 placing battey + rot encoder
    [LT2.kicad_pcb, LT2.kicad_sch, LT2.scad, parts.scad]
2025-10-18 some routing
    [LT2.kicad_pcb]
2025-10-19 LT2 rev0 done, ordered
    [LT2.kicad_pcb, LT2.kicad_sch, bom.csv, positions.csv, positions_unedited.csv]
2025-10-22 started stm32 LT2
    [LT2.scad]
2025-10-22 started with encoder + display
2025-10-22 disp, charlieplexing driver
2025-10-29 testing 1
    encoder left/right works,
    encoder btn single, double and long pressed works, but timing is still a
    bit long
    but display (charlieplexing) does not work propperly, although
    somethings work
    [LT2.ioc, disp.c, disp.h, encoder.c, gpio.c, main.c]
2025-10-29 added more timers, rtc WUT works
2025-10-29 timing tested: 1 s is really 1 s, also casing -> openscad
    [LT2.scad]
2025-10-30 case v1.1
    [LT2.scad, parts.scad]
2025-11-01 main_task structure and events, encoder use TIM21
    [LT2.scad]
2025-11-23 case minor adjustments for vibra motor
    [LT2.scad, parts.scad]
