mwuerms/ledtimer/(notices)

Notices in the files:
stmcubeide/LT2/Core/Inc/main.h:
Copyright (c) 2025 STMicroelectronics.
All rights reserved.
This software is licensed under terms that can be found in the LICENSE file
stmcubeide/LT1/Core/Src/gpio.c:
Copyright (c) 2023 STMicroelectronics.
